simonliu009/epdiy/(commit log)

2021-01-02 remove battery protection, simplify
    [epaper-breakout.kicad_pcb, epaper-breakout.sch]
2021-01-03 add battery voltage sensing, routing
    [epaper-breakout.kicad_pcb, epaper-breakout.sch]
2021-01-05 add decoupling cap to battery voltage sensor
    [epaper-breakout.kicad_pcb, epaper-breakout.sch]
2021-01-06 change board license to CC-BY-SA 4.0 (#31)
    [epaper-breakout.sch]
2021-01-08 v5: swap gpio 0 and 19
    [epaper-breakout.kicad_pcb, epaper-breakout.sch]
2021-01-14 v5 prototype
    [BOM.csv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]
