simonliu009/epdiy/(notices)

Notices in the files:
hardware/epaper-breakout/epaper-breakout.sch:
License: CC-BY-SA-4.0
parts and their libraries:
Copyright 2016 Accelerated Designs. All rights reserved.
